Ashtonantony28/drone-design/out/cad/render_side.png

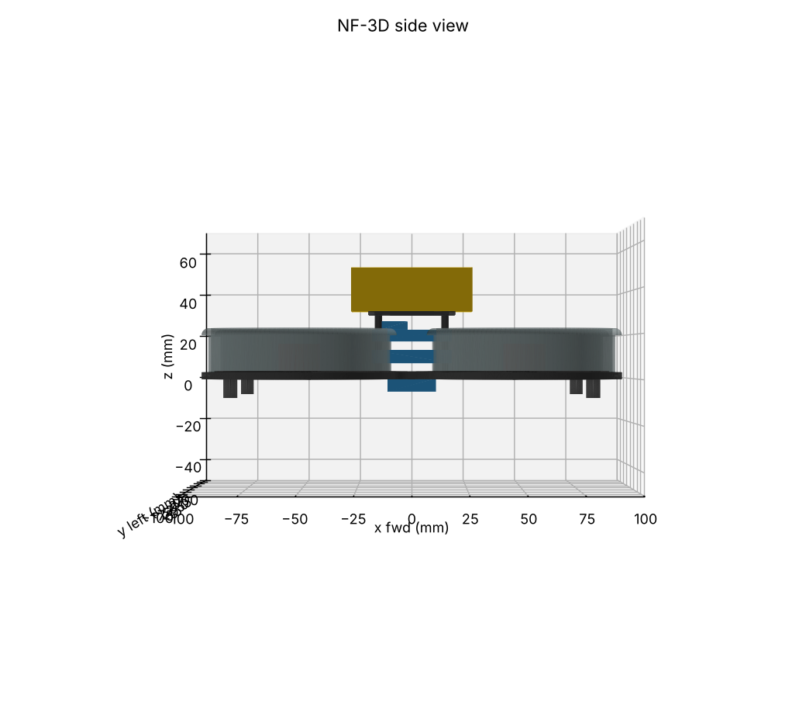
out/cad/render_side.png
