Ashtonantony28/drone-design/out/cad/render_top.png

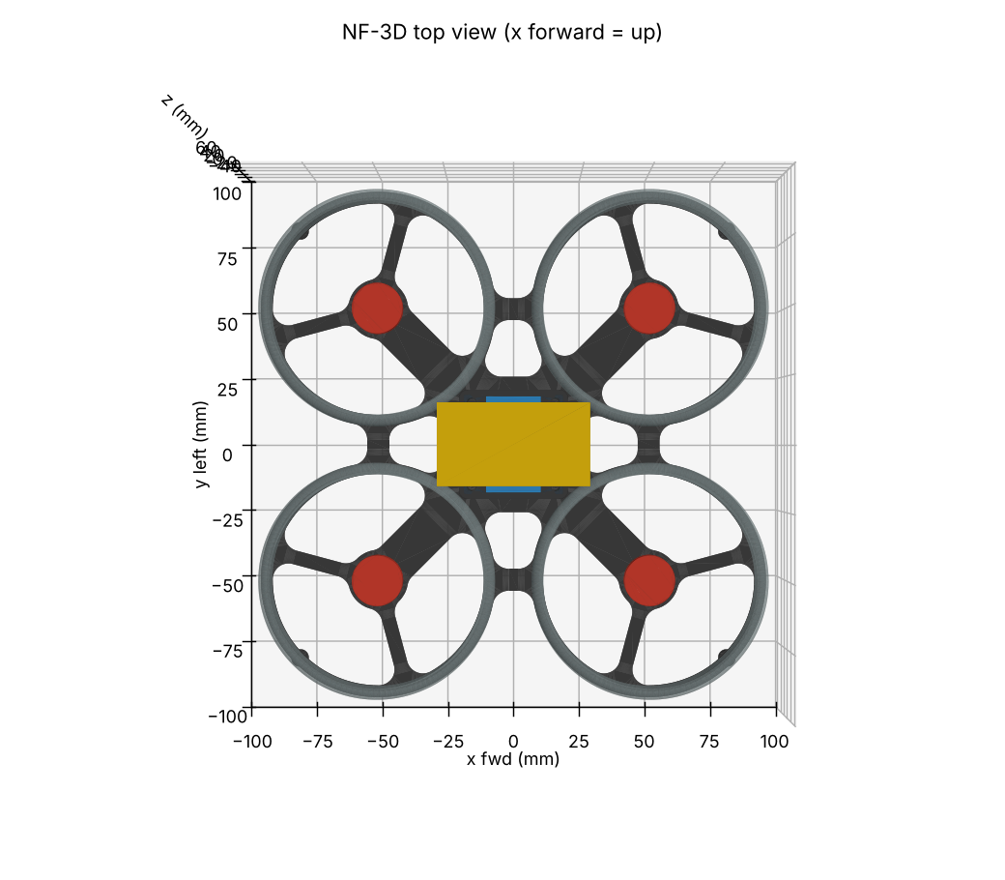
out/cad/render_top.png
