Ashtonantony28/drone-design/out/cad/nf3d_assembly.step

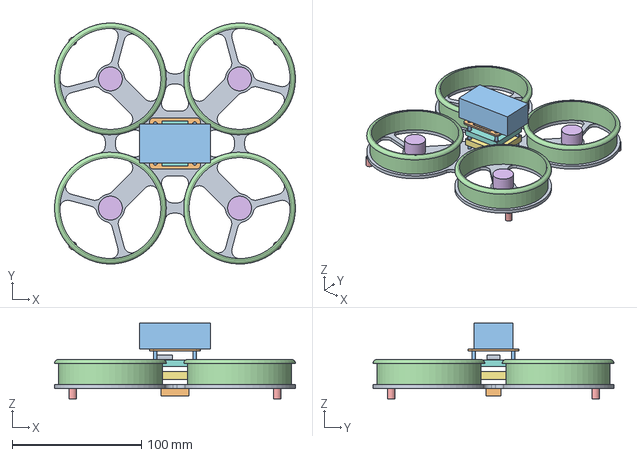
[picture p4: CAD file, 2026-11-12]
out/cad/nf3d_assembly.step
186.6 x 186.6 x 58.5 mm
