Ashtonantony28/drone-design/ecad/fab/nf_fc.step

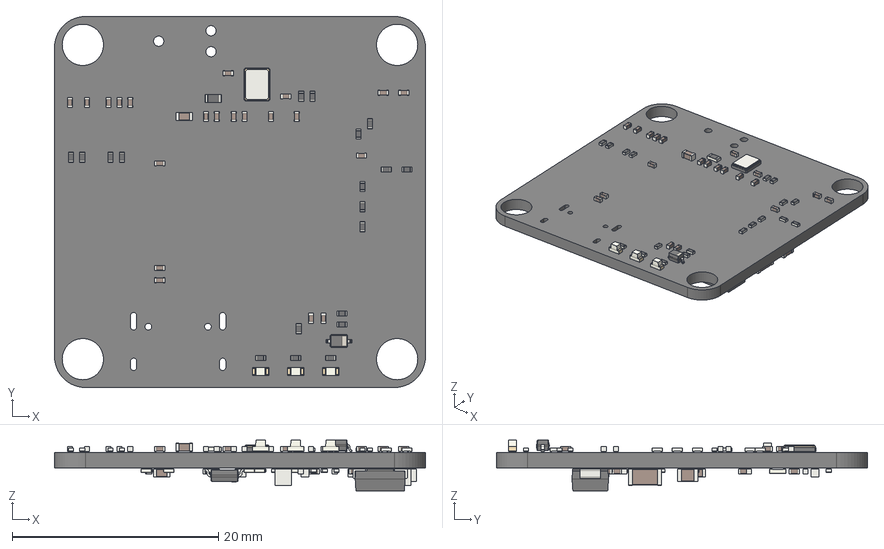
[picture p5: CAD file, 2026-11-13]
ecad/fab/nf_fc.step
36.0 x 36.0 x 4.95 mm
C_0402_1005Metric x 29
LED_0603_1608Metric x 3
D_SOD-323
R_0402_1005Metric x 41
R_0603_1608Metric x 2
Crystal_SMD_3225-4Pin_3.2x2.5mm
C_0603_1608Metric x 5
C_1206_3216Metric x 3
C_0805_2012Metric x 3
D_SOD-123
D_SMB
nf_fc_PCB
