Ashtonantony28/drone-design/out/cad/bottom_plate.step

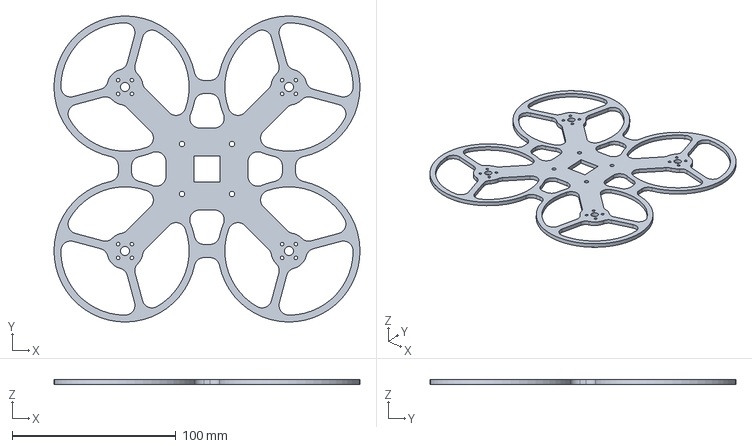
[picture p6: CAD file, 2026-11-12]
out/cad/bottom_plate.step
186.6 x 186.6 x 3.00 mm
