Ashtonantony28/drone-design/out/cad/top_plate.step

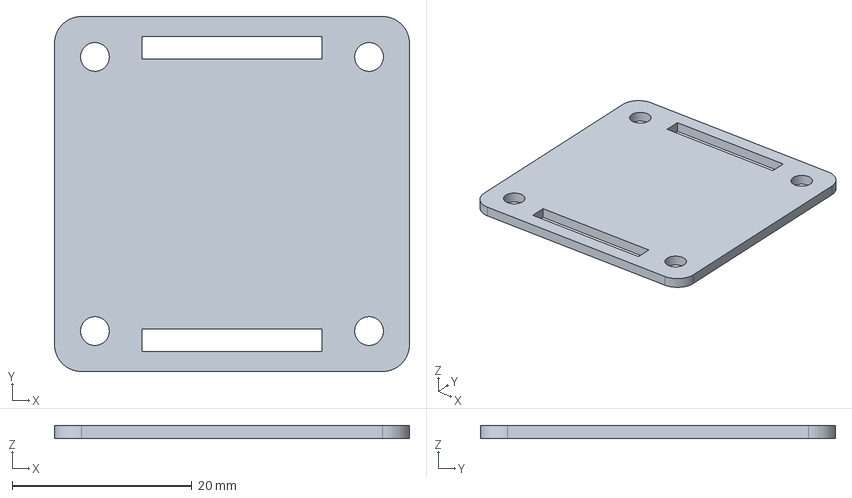
[picture p7: CAD file, 2026-11-12]
out/cad/top_plate.step
39.5 x 39.5 x 1.50 mm
