Ashtonantony28/drone-design/out/cad/duct.stl

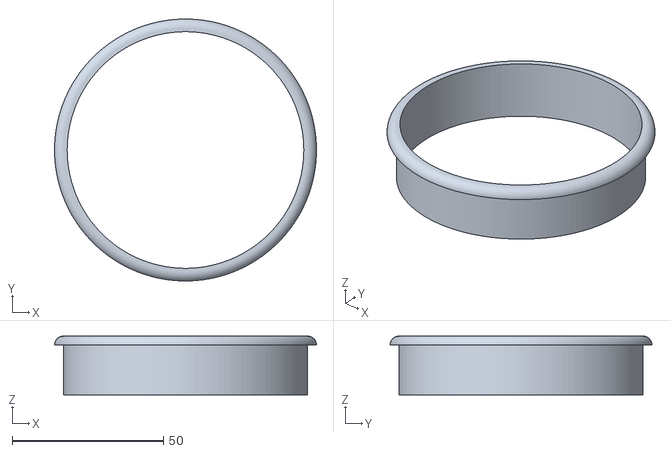
[picture p8: CAD file, 2026-11-12]
out/cad/duct.stl
86.6 x 86.6 x 19.5
