Ashtonantony28/drone-design/out/cad/foot.stl

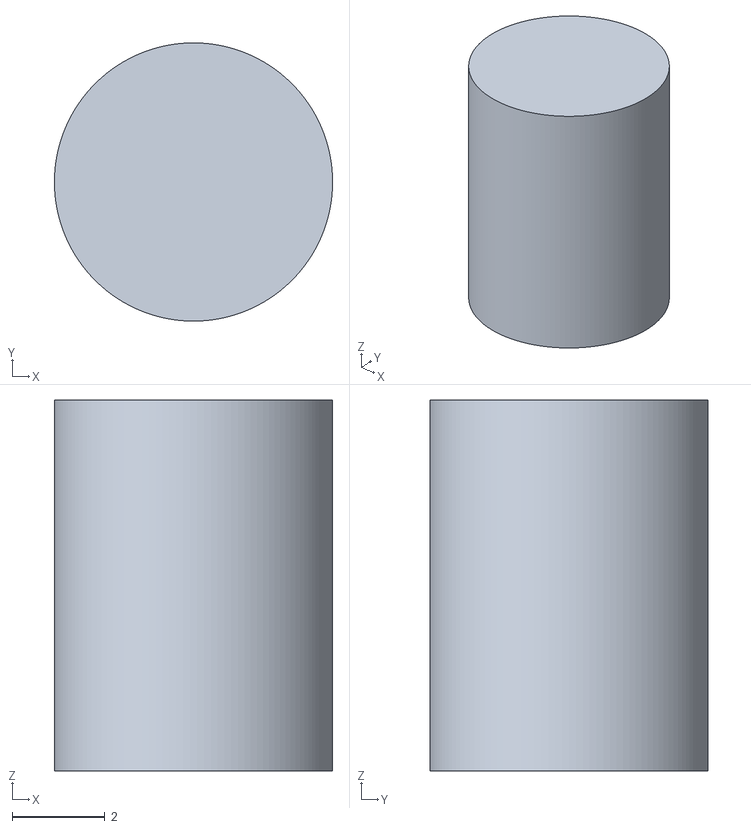
[picture p9: CAD file, 2026-11-12]
out/cad/foot.stl
6.00 x 6.00 x 8.00
