Ashtonantony28/drone-design/(list of files, cad)

Other CAD files:
out/cad/bottom_plate.dxf
out/cad/top_plate.dxf
