Ashtonantony28/drone-design/ecad/boards/nf_fc/layout/nf_fc/nf_fc.kicad_pcb

## KiCad design ecad/boards/nf_fc/layout/nf_fc/nf_fc.kicad_pcb (2026-11-13)

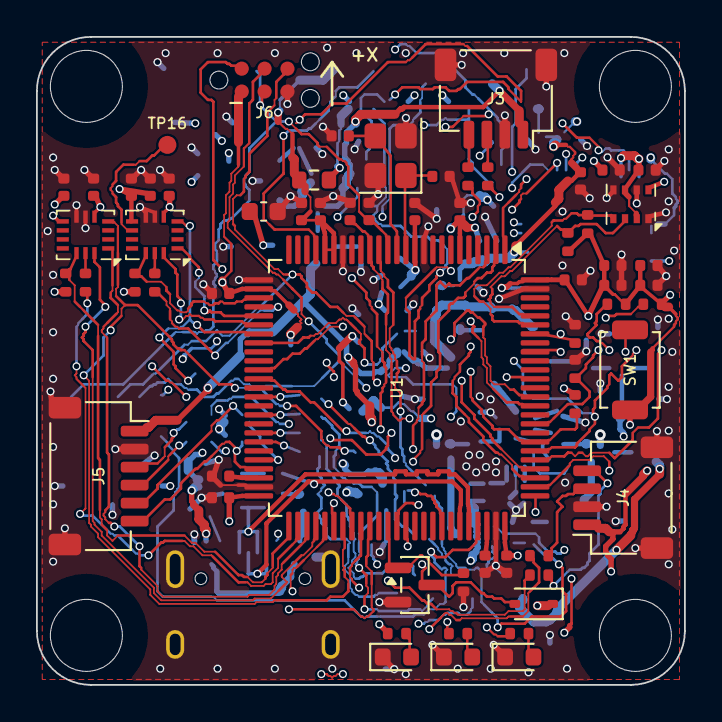
[picture p10: board nf_fc.kicad_pcb from above]

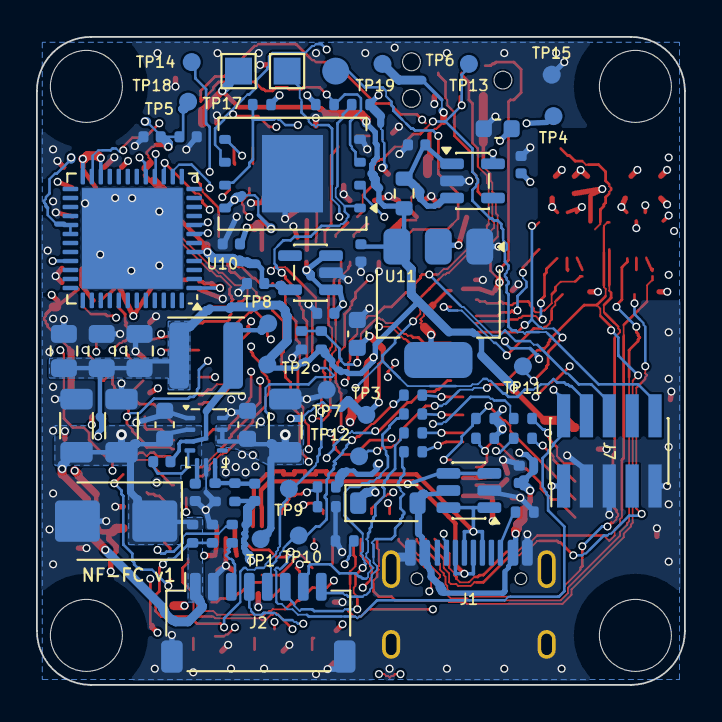
[picture p11: board nf_fc.kicad_pcb from below]

Board: 4 copper layers, 36.0 x 36.0 mm, 143 parts (76 on the bottom side), 90 nets.

Parts:
C1, C2, C3, C4, C5, C6, C7, C8, C9, C10, C11, C14, C15, C16, C19, C20, C24, C25, C26, C27, C28, C29, C34, C49: 100nF 16V X7R; C_0402_1005Metric
C12: 10nF 50V X7R; C_0402_1005Metric
C13, C21, C22: 2.2uF 6.3V X5R; C_0402_1005Metric
C17, C18: 12pF 50V C0G; C_0402_1005Metric
C23, C36, C38, C39, C41, C42, C46: 1uF 25V X5R; C_0402_1005Metric
C30, C37, C40: 10uF 10V X5R; C_0603_1608Metric
C31, C32, C33: 22uF 25V X5R; C_0805_2012Metric
C35: 20pF 50V C0G; C_0402_1005Metric
C43, C44, C45: 2.2uF 50V X7R; C_1206_3216Metric
C47, C48: 220nF 100V X7R; C_0603_1608Metric
D1: B5819W; D_SOD-123
D2: 1N4148WS; D_SOD-323
D3: 26V TVS Diode; D_SMB
D4: LED GREEN 2.7–3.2V (3V nom.); LED_0603_1608Metric
D5: LED BLUE 2.7–3.2V (3V nom.); LED_0603_1608Metric
D6: LED RED 2V 10%; LED_0603_1608Metric
FB1, FB2: 600 1A 100MHz; R_0603_1608Metric
H1, H2, H3, H4: MountingHole; MountingHole_4.0mm_M3_Grommet
J1: TYPE-C-31-M-12; USB_C_Receptacle_HRO_TYPE-C-31-M-12
J2: SM08B-SRSS-TB(LF)(SN); JST_SH_SM08B-SRSS-TB_1x08-1MP_P1.00mm_Horizontal
J3, J4: SM04B-SRSS-TB(LF)(SN); JST_SH_SM04B-SRSS-TB_1x04-1MP_P1.00mm_Horizontal
J5: SM06B-SRSS-TB(LF)(SN); JST_SH_SM06B-SRSS-TB_1x06-1MP_P1.00mm_Horizontal
J6: Conn_ARM_SWD_TagConnect_TC2030-NL; Tag-Connect_TC2030-IDC-NL_2x03_P1.27mm_Vertical
J7: FTSH-105-01-F-DV-K; PinHeader_2x05_P1.27mm_Vertical_SMD
L1: 6.8uH; L_Sunlord_SWPA4030S
Q1: AO3400A; SOT-23
R1, R2: 4.7k 1%; R_0402_1005Metric
R3, R6, R9, R10, R15, R16: 100 1%; R_0402_1005Metric
R4, R5: 2.2k 1%; R_0402_1005Metric
R7, R8: 5.1k 1%; R_0402_1005Metric
R11, R12, R13, R14: 33 1%; R_0402_1005Metric
R17, R18, R19, R20, R22, R24, R25, R26, R28, R31, R32, R35, R37, R38: 10k 1%; R_0402_1005Metric
R21, R23: 0; R_0402_1005Metric
R27, R30: 100k 1%; R_0402_1005Metric
R29: 24.9k 1%; R_0402_1005Metric
R33, R34, R39, R40, R41: 1k 1%; R_0402_1005Metric
R36: 20k 1%; R_0402_1005Metric
SW1: TS-1088-AR02016; SW_SPST_TS-1088-xR020
TP1, TP2, TP3, TP4, TP5, TP6, TP7, TP8, TP9, TP10, TP11, TP12, TP13, TP14, TP15, TP16: TestPoint_Small; TestPoint_Pad_D1.0mm
TP17, TP18: TestPoint_Small; TestPoint_Pad_1.5x1.5mm
TP19: TestPoint_Small; TestPoint_Pad_D1.5mm
U1: STM32H743VIT6; LQFP-100_14x14mm_P0.5mm
U2: ICM-42688-P; Bosch_LGA-14_3x2.5mm_P0.5mm
U3: BMI270; Bosch_LGA-14_3x2.5mm_P0.5mm
U4: DPS310XTSA1; Bosch_LGA-8_2x2.5mm_P0.65mm_ClockwisePinNumbering
U5: W25N01GVZEIG; WSON-8-1EP_8x6mm_P1.27mm_EP3.4x4.3mm
U6: LMR36015FBRNXR; Texas_RNX0012C_VQFN-14-11-1EP_2x3mm_P0.5mm_EP0.25x1.825mm
U7: LDL1117S33R; SOT-223-3_TabPin2
U8: LP5907MFX-3.3/NOPB; SOT-23-5
U9: USBLC6-2SC6; SOT-23-6
U10: iCE40UP5K-SG48ITR; QFN-48-1EP_7x7mm_P0.5mm_EP5.6x5.6mm
U11: TLV75512PDBVR; SOT-23-5
Y1: 8MHz; Crystal_SMD_3225-4Pin_3.2x2.5mm

Connections:
1V2_FPGA: C8.1, C9.1, C10.1, C42.1, TP5.1, U10.5, U10.29, U10.30, U11.5
3V3_D: C1.1, C2.1, C4.1, C5.1, C6.1, C7.1, C11.1, C20.1, C25.1, C26.1, C27.1, C28.1, C29.1, C30.1, C37.1, C41.1, FB2.1, J6.1, J7.1, R1.2, R2.2, R4.2, R5.2, R17.2, R18.2, R19.2, R25.2, R26.2, R28.2, R39.1, SW1.1, TP3.1, U1.6, U1.11, U1.27, U1.50, U1.75, U1.100, U4.2, U4.6, U4.8, U5.8, U7.2, U10.1, U10.22, U10.24, U10.33, U11.1, U11.3
3V3_IMU: C12.1, C13.1, C14.1, C15.1, C16.1, C39.1, C40.1, R20.2, R22.2, TP4.1, U2.5, U2.8, U3.5, U3.8, U8.5
5V: C31.1, C32.1, C33.1, C35.1, C36.1, D1.1, D2.1, FB1.1, J3.1, J4.1, J5.1, L1.2, R30.1, R32.1, TP2.1, TP18.1, U7.3
5V_SENSE: R31.1, R32.2, U1.33
AUX_RX: R3.1, U1.64
AUX_SCL: J5.5, R4.1, U1.46
AUX_SDA: J5.6, R5.1, U1.47
AUX_TX: R6.1, U1.63
BARO_SCL: R1.1, U1.95, U4.4
BARO_SDA: R2.1, U1.96, U4.3
BEEPER: Q1.1, R38.1, U1.62
BOOT0: R24.1, SW1.2, TP14.1, U1.94
CONN.AUX_RX_CONN: J5.4, R3.2
CONN.AUX_TX_CONN: J5.3, R6.2
CONN.ESC_M2: J2.6, R12.2
CONN.ESC_M3: J2.7, R13.2
CONN.ESC_M4: J2.8, R14.2
CONN.FLOW_RX_CONN: J4.4, R9.2
CONN.FLOW_TX_CONN: J4.3, R10.2
CONN.RC_RX_CONN: J3.4, R15.2
CONN.RC_TX_CONN: J3.3, R16.2
CONN.USB_CC1: J1.A5, R7.1
CONN.USB_CC2: J1.B5, R8.1
CURR_SENSE: C49.1, R33.2, U1.16
ESC_CUR: J2.3, R33.1
ESC_M1: J2.5, R11.2, TP10.1
ESC_TLM: J2.4, U1.37
FLOW_RX: R9.1, U1.56
FLOW_TX: R10.1, U1.55
FPGA_CDONE: R25.1, U1.82, U10.7
FPGA_CRESET_B: R26.1, U1.81, U10.8
FPGA_IRQ: R27.1, U1.84, U10.23
FPGA_MISO: U1.79, U10.14
FPGA_MOSI: U1.80, U10.17
FPGA_SCK: U1.78, U10.15
FPGA_SS_B: R28.1, U1.77, U10.16
GND: C1.2, C2.2, C3.2, C4.2, C5.2, C6.2, C7.2, C8.2, C9.2, C10.2, C11.2, C12.2, C13.2, C14.2, C15.2, C16.2, C17.2, C18.2, C19.2, C20.2, C21.2, C22.2, C23.2, C24.2, C25.2, C26.2, C27.2, C28.2, C29.2, C30.2, C31.2, C32.2, C33.2, C36.2, C37.2, C38.2, C39.2, C40.2, C41.2, C42.2, C43.2, C44.2, C45.2, C46.2, C47.2, C48.2, C49.2, D3.2, D4.1, D5.1, D6.1, J1.A1, J1.A12, J1.B1, J1.B12, J1.SH, J2.2, J2.MP, J3.2, J3.MP, J4.2, J4.MP, J5.2, J5.MP, J6.5, J7.3, J7.5, J7.9, Q1.2, R7.2, R8.2, R24.2, R27.2, R29.2, R31.2, R34.2, R36.2, R38.2, TP7.1, TP15.1, U1.10, U1.19, U1.26, U1.49, U1.74, U1.99, U2.6, U2.7, U3.6, U3.7, U4.1, U4.5, U4.7, U5.4, U5.9, U6.1, U6.6, U6.11, U7.1, U8.2, U9.2, U10.49, U11.2, Y1.2, Y1.4
IMU.IMUA_CLKIN: TP16.1, U2.9
IMU.IMUA_SCK_R: R21.2, U2.13
IMU.IMUB_SCK_R: R23.2, U3.13
IMUA_CS: R20.1, U1.28, U2.12
IMUA_INT1: TP11.1, U1.32, U2.4
IMUA_MISO: U1.30, U2.1
IMUA_MOSI: U1.31, U2.14
IMUA_SCK: R21.1, U1.29
IMUB_CS: R22.1, U1.51, U3.12
IMUB_INT1: TP12.1, U1.57, U3.4
IMUB_MISO: U1.53, U3.1
IMUB_MOSI: U1.54, U3.14
IMUB_SCK: R23.1, U1.52
LED0: R40.1, U1.2
LED1: R41.1, U1.3
LED_STRIP: TP19.1, U1.22
MCU.HSE_IN: C17.1, U1.12, Y1.1
MCU.HSE_OUT: C18.1, U1.13, Y1.3
MCU.VCAP_1: C21.1, U1.48
MCU.VCAP_2: C22.1, U1.73
MOTOR0: R11.1, U1.39
MOTOR1: R12.1, U1.41
MOTOR2: R13.1, U1.43
MOTOR3: R14.1, U1.44
NRST: C19.1, J6.3, J7.10, TP13.1, U1.14
PWR.BUCK_BOOT: C34.1, U6.4
PWR.BUCK_FB: C35.2, R29.1, R30.2, U6.7
PWR.BUCK_SW: C34.2, L1.1, TP8.1, U6.3, U6.12
PWR.BUCK_VCC: C46.1, U6.5
PWR.IMU_LDO_IN: C38.1, FB1.2, U8.1, U8.3
QSPI_CLK: U1.36, U5.6
QSPI_IO0: U1.58, U5.5
QSPI_IO1: U1.59, U5.2
QSPI_IO2: R17.1, U1.1, U5.3
QSPI_IO3: R18.1, U1.60, U5.7
QSPI_NCS: R19.1, U1.92, U5.1
RX_RX: R15.1, U1.87
RX_TX: R16.1, U1.86
SWCLK: J6.4, J7.4, U1.76
SWDIO: J6.2, J7.2, U1.72
SWO: J6.6, J7.6, U1.89
UI.BUZZER_N: D2.2, Q1.3, TP17.1
UI.LED_PWR_A: D4.2, R39.2
UI.LED_STATUS_A: D5.2, R40.2
UI.LED_WARN_A: D6.2, R41.2
USB_N: J1.A7, J1.B7, U1.70, U9.3, U9.4
USB_P: J1.A6, J1.B6, U1.71, U9.1, U9.6
VBAT: C43.1, C44.1, C45.1, C47.1, C48.1, D3.1, J2.1, R35.1, TP1.1, U6.2, U6.9, U6.10
VBAT_SENSE: R34.1, R35.2, TP9.1, U1.15
VBUS: C3.1, D1.2, J1.A4, J1.A9, J1.B4, J1.B9, R37.1, U9.5
VBUS_SENSE: R36.1, R37.2, U1.68
VDDA: C23.1, C24.1, FB2.2, TP6.1, U1.20, U1.21
