Ashtonantony28/drone-design/out/vehicle_reference.yaml

mass: 0.25
inertia:
- 0.00025
- 0.00025
- 0.0004
arm_xy: 0.046
thrust_max: 4.5
thrust_curve_a: 0.7
yaw_torque_coeff: 0.006
motor_tau_up: 0.03
motor_tau_down: 0.045
idle_command: 0.05
lin_drag:
- 0.1
- 0.1
- 0.15
rot_drag:
- 1.0e-05
- 1.0e-05
- 1.5e-05
gravity: 9.81
control_rate_hz: 500
rate_loop_hz: 1000
latency_s: 0.003
max_body_rate:
- 10.0
- 10.0
- 6.0
