Ashtonantony28/drone-design/(commit log)

2026-11-12 NF-3D airframe: spec, build123d frame, mass/clearance checks, propulsion model, FEA, flight-sim harness
    Single-source spec (spec/vehicle.yaml) feeds the CAD, the mass model, the
    propulsion model and the flight simulator, so changing a dimension or part
    re-runs every check against it. Frame went through five FEA iterations
    (crash SF 0.5 -> 1.7) before passing.
    Claude-Session: https://claude.ai/code/session_01VH3AybCxAwSgFsi8oAjL9r
    [bottom_plate.dxf, bottom_plate.step, duct.stl, foot.stl, nf3d_assembly.step, top_plate.dxf, top_plate.step]
2026-11-12 NF-3D: Zener/KiCad flight controller, flight validation, README (#1)
    * WIP (paused): Zener FC schematic in progress, policy fine-tune log
    Work paused at the user's request. ecad/ is an unfinished phase-1 Zener
    schematic (not yet building/checked); the NF-3D policy fine-tune stopped at
    iteration ~370/440 (checkpoint kept outside git).
    * ecad: complete Zener FC schematic and netlist/BOM checks against the design package
    Phase 1 of the flight-controller ECAD work. The paused WIP built, but parts
    were renumbered by pcb (U1 was the barometer), nothing compared the ne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
    [nf_fc-B_Cu.gbr, nf_fc-B_Mask.gbr, nf_fc-B_Paste.gbr, nf_fc-B_Silkscreen.gbr, nf_fc-Edge_Cuts.gbr, nf_fc-F_Cu.gbr, nf_fc-F_Mask.gbr, nf_fc-F_Paste.gbr]
2026-11-13 PCB pre-fab fixes; fly the v3 policy on NF-3D with a thrust calibration (#2)
    PCB: 90 ohm matched USB pair, QSPI matched to 1.79 mm, power tracks and L4 pours, track under 0.127 mm down from 78 % to 18 %, DRC 0/0/0, 26 layout/design tests.
    Flight: PPO fine-tuning loses v3's hover precision even on the reference vehicle, so instead v3's collective command is scaled to the airframe (mass and thrust ratio). Both NF-3D corners are within 3 points of the reference vehicle.
    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
    [nf_fc-B_Cu.gbr, nf_fc-B_Mask.gbr, nf_fc-B_Paste.gbr, nf_fc-B_Silkscreen.gbr, nf_fc-Edge_Cuts.gbr, nf_fc-F_Cu.gbr, nf_fc-F_Mask.gbr, nf_fc-F_Paste.gbr]
